makadiyapreet/ArgusShield/docs/images/dashboard-nominal.png

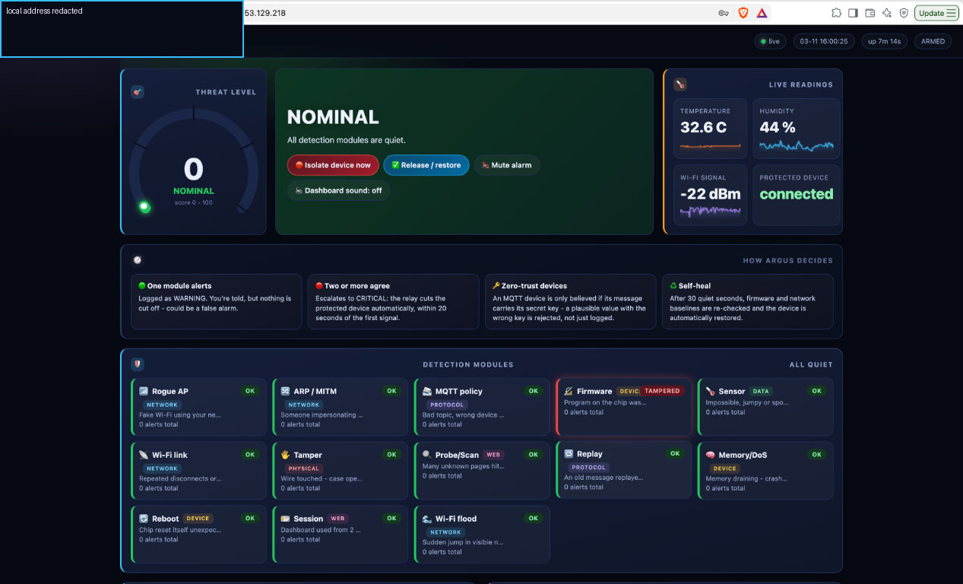
docs/images/dashboard-nominal.png
